aidanpren/BipedV1/README.md

# BipedV1
An open-source balancing biped project. Ran off a Raspberry PI using ROS2 Jazzy Jalisco.
