aidanpren/BipedV1/rock_analysis/rock_A_baseline_analysis.png

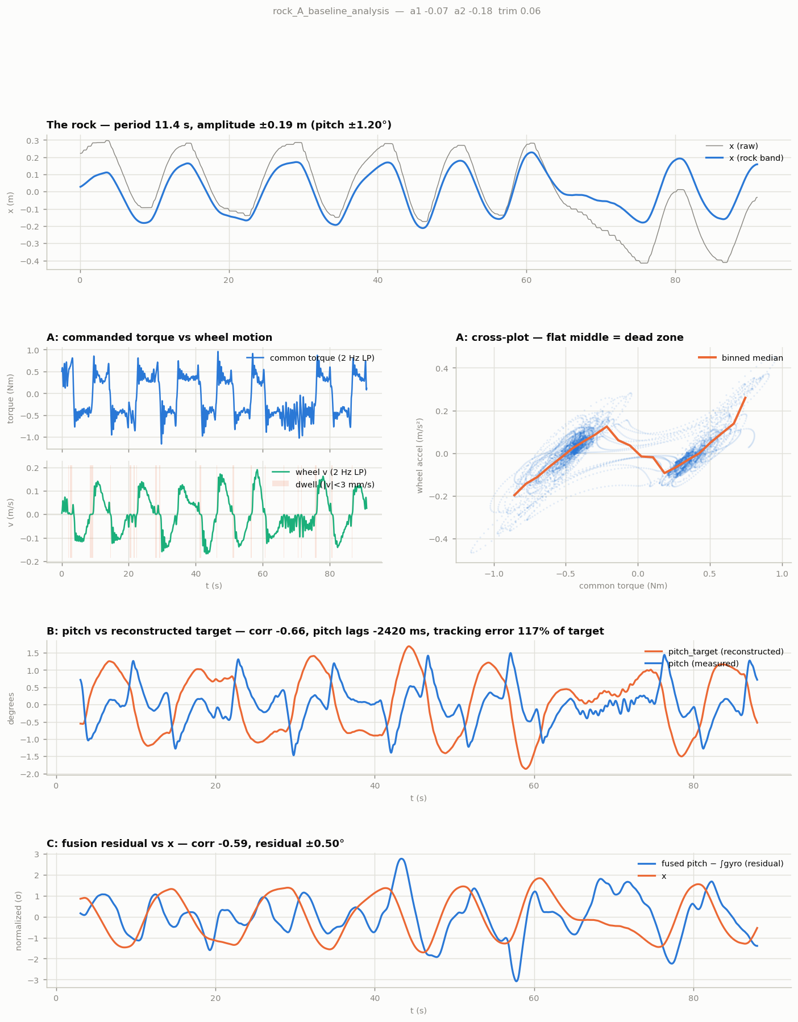
rock_analysis/rock_A_baseline_analysis.png
