aidanpren/BipedV1/rock_analysis/rock_B_nodither_analysis.png

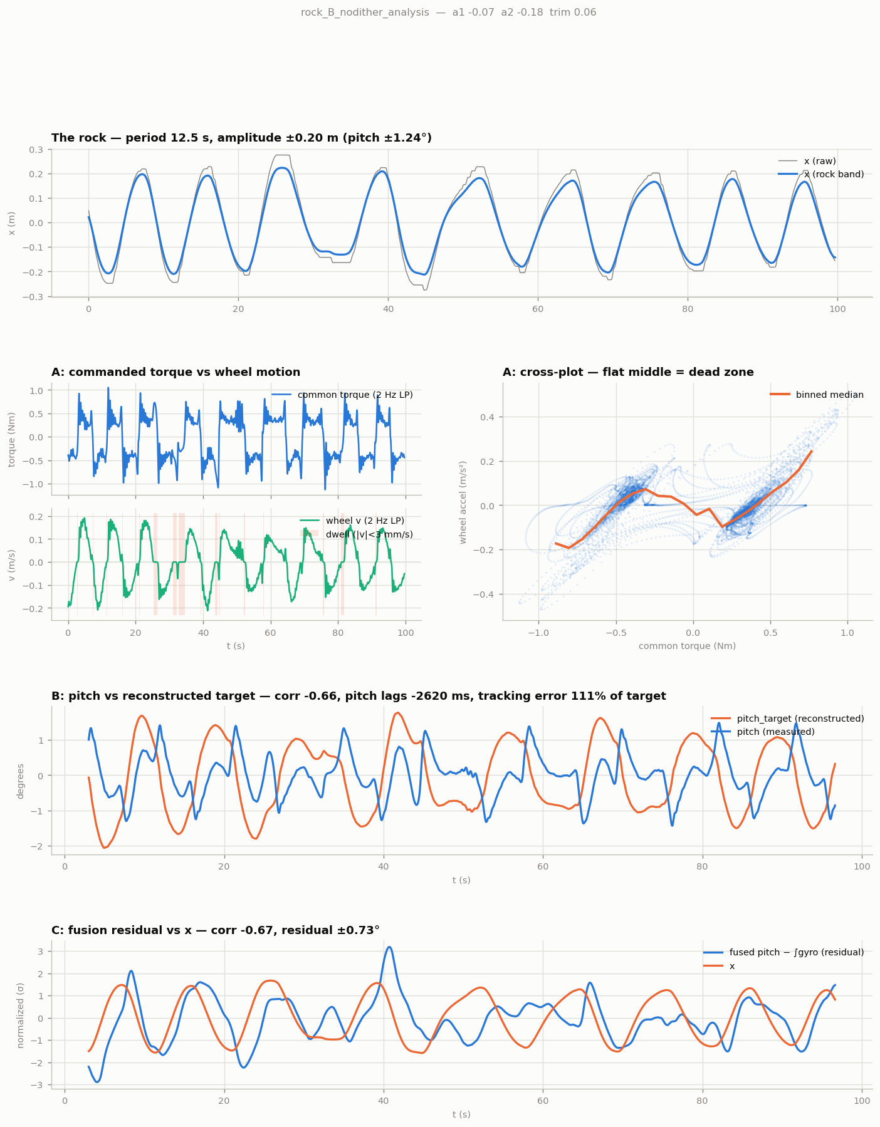
rock_analysis/rock_B_nodither_analysis.png
