aidanpren/BipedV1/rock_analysis/rock_C_frictionff_analysis.png

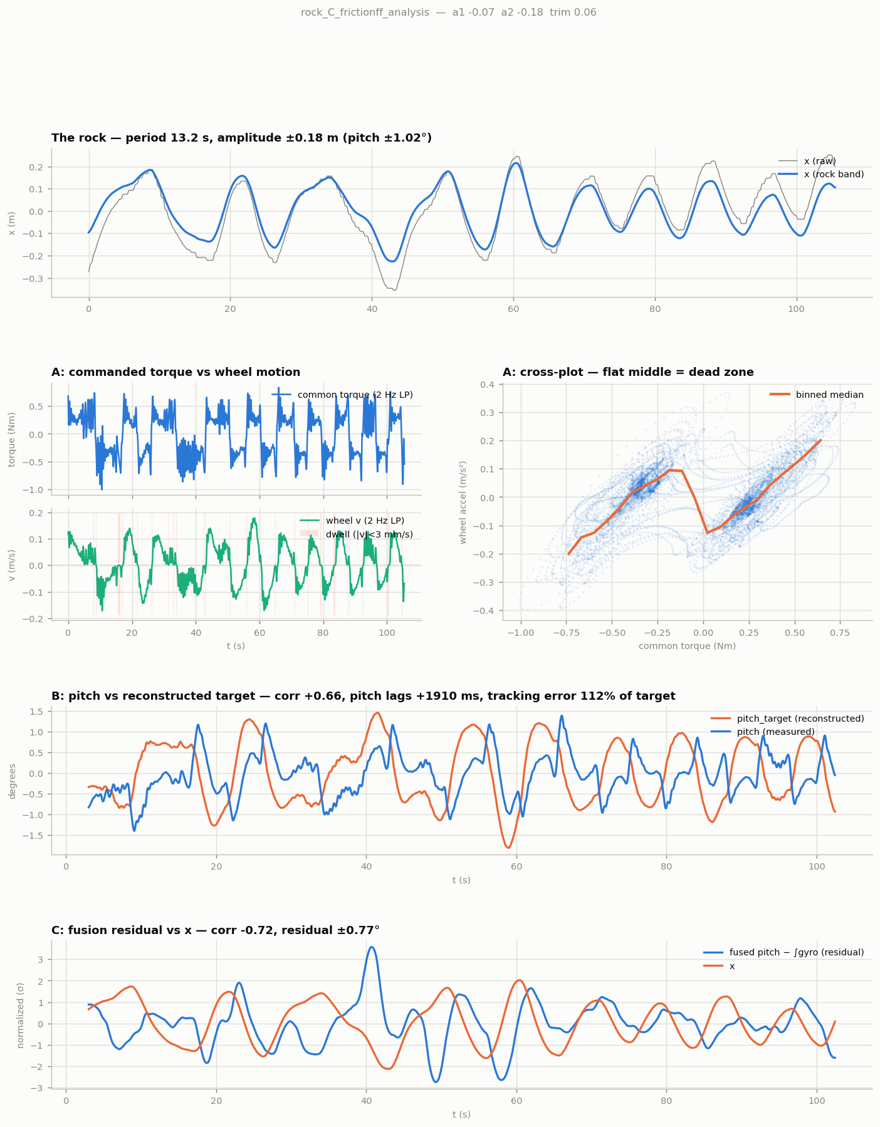
rock_analysis/rock_C_frictionff_analysis.png
