aidanpren/BipedV1/src/robot_description/meshes/_8108_8__X2_7B805316_X0__1.stl

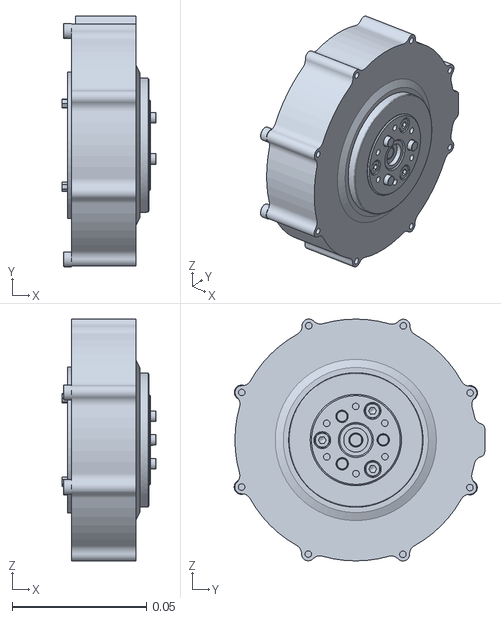
[picture p4: CAD file, 2026-07-09]
src/robot_description/meshes/_8108_8__X2_7B805316_X0__1.stl
0.035 x 0.0933 x 0.0901
