aidanpren/BipedV1/src/robot_description/meshes/Part_2_1.stl

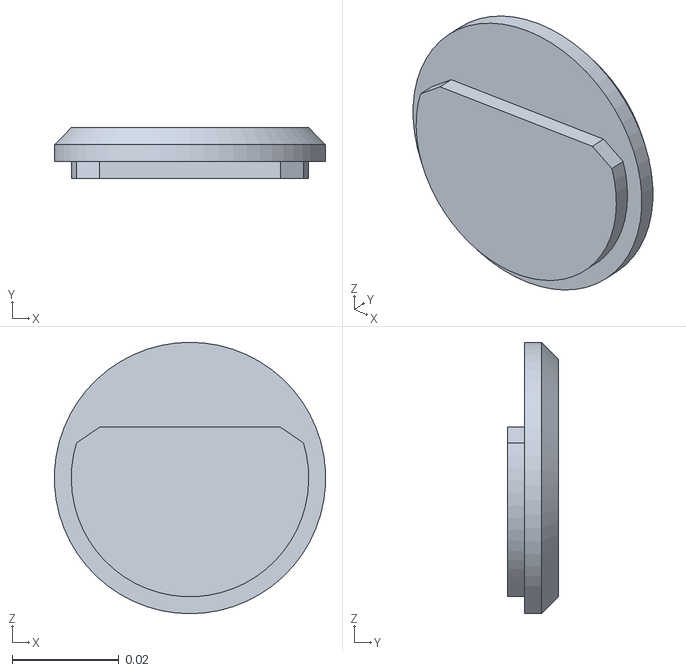
[picture p5: CAD file, 2026-07-09]
src/robot_description/meshes/Part_2_1.stl
0.0507 x 0.00952 x 0.0508
