aidanpren/BipedV1/src/robot_description/meshes/Lidar_A1M8_3.stl

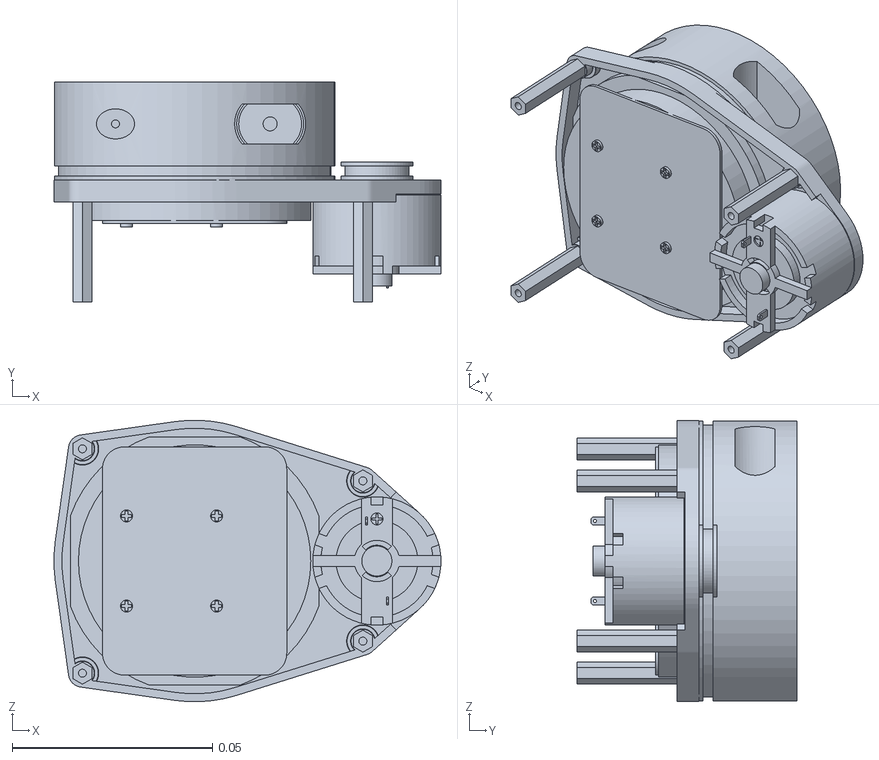
[picture p6: CAD file, 2026-07-09]
src/robot_description/meshes/Lidar_A1M8_3.stl
0.0966 x 0.055 x 0.0702
