aidanpren/BipedV1/src/robot_description/meshes/Part_1_5.stl

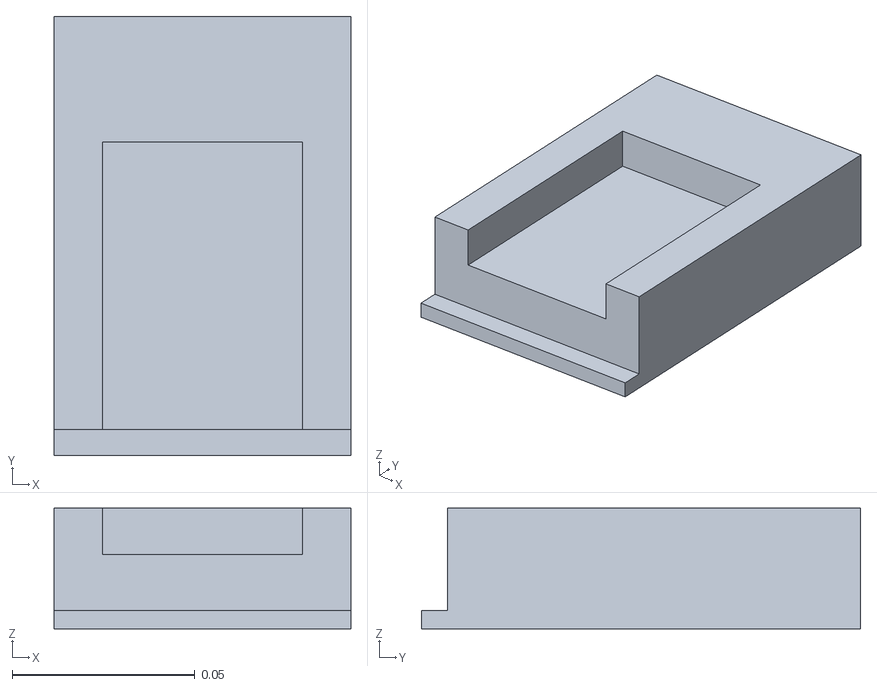
[picture p7: CAD file, 2026-07-09]
src/robot_description/meshes/Part_1_5.stl
0.0813 x 0.12 x 0.033
