aidanpren/BipedV1/src/robot_description/meshes/Part_2.stl

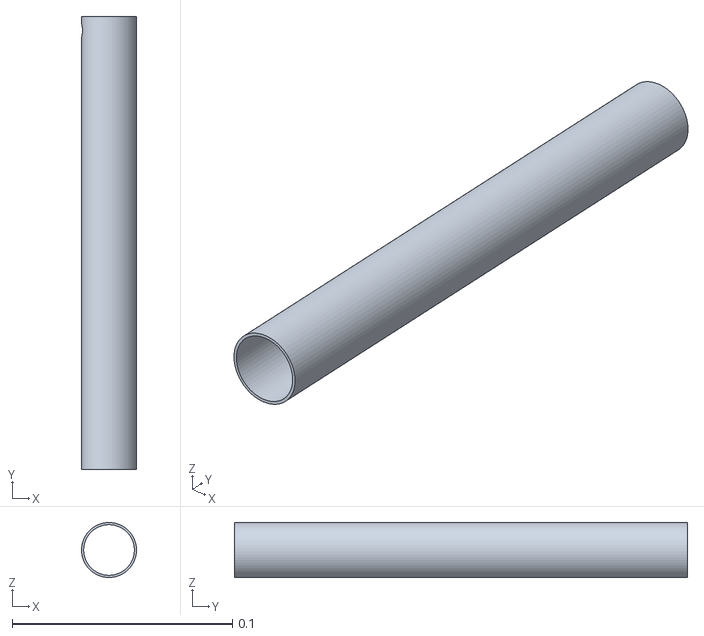
[picture p8: CAD file, 2026-07-09]
src/robot_description/meshes/Part_2.stl
0.025 x 0.206 x 0.025
