aidanpren/BipedV1/src/robot_description/meshes/Part_1_1.stl

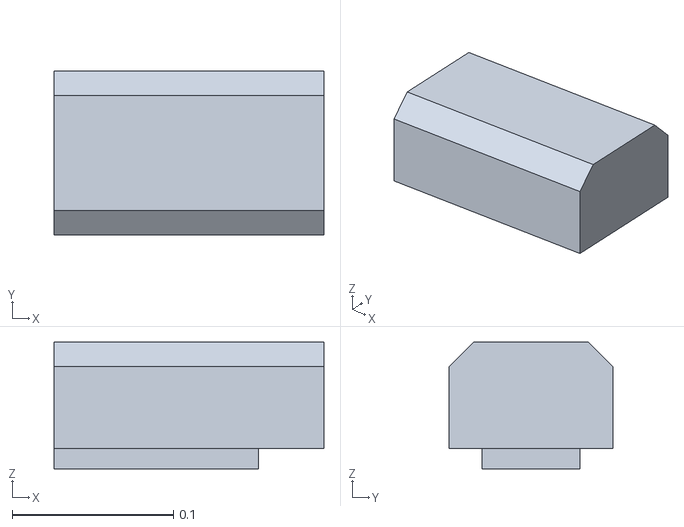
[picture p9: CAD file, 2026-07-09]
src/robot_description/meshes/Part_1_1.stl
0.168 x 0.102 x 0.0787
