aidanpren/BipedV1/src/robot_description/meshes/Lidar_A1M8_6.stl

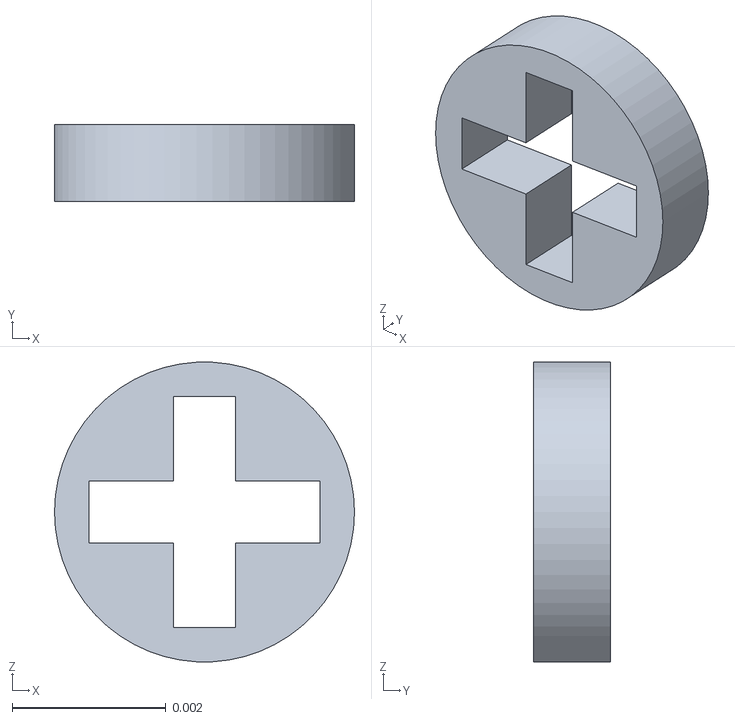
[picture p10: CAD file, 2026-07-09]
src/robot_description/meshes/Lidar_A1M8_6.stl
0.0039 x 0.001 x 0.00389
