aidanpren/BipedV1/src/robot_description/meshes/Part_5.stl

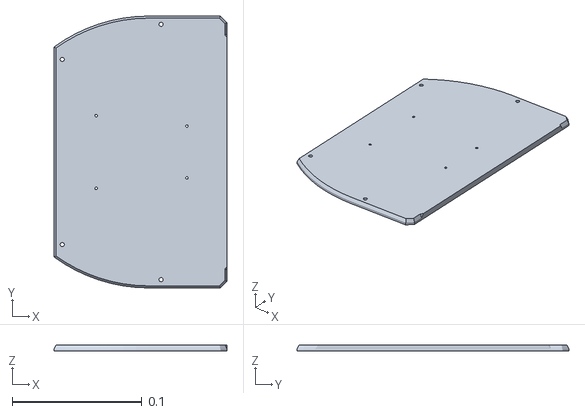
[picture p11: CAD file, 2026-07-09]
src/robot_description/meshes/Part_5.stl
0.133 x 0.21 x 0.00476
