aidanpren/BipedV1/src/robot_description/meshes/Part_1_Mirrored.stl

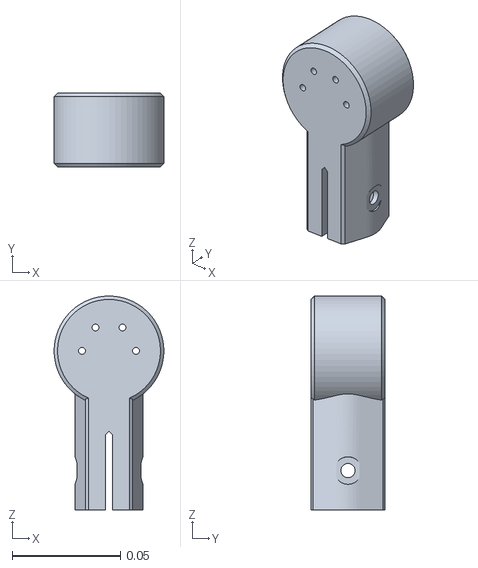
[picture p12: CAD file, 2026-07-09]
src/robot_description/meshes/Part_1_Mirrored.stl
0.0507 x 0.0343 x 0.0991
