aidanpren/BipedV1/src/robot_description/meshes/Part_1_Mirrored_1.stl

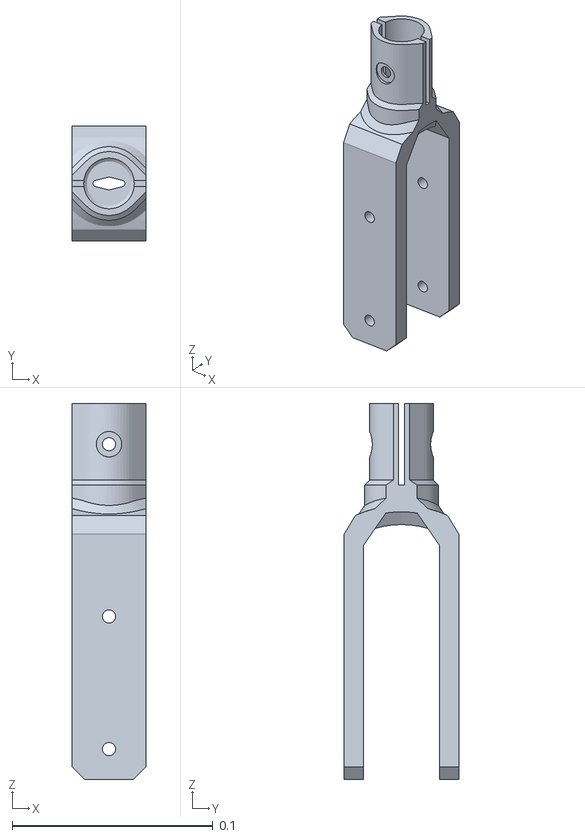
[picture p13: CAD file, 2026-07-09]
src/robot_description/meshes/Part_1_Mirrored_1.stl
0.0367 x 0.0571 x 0.187
