aidanpren/BipedV1/src/robot_description/meshes/Part_3_1.stl

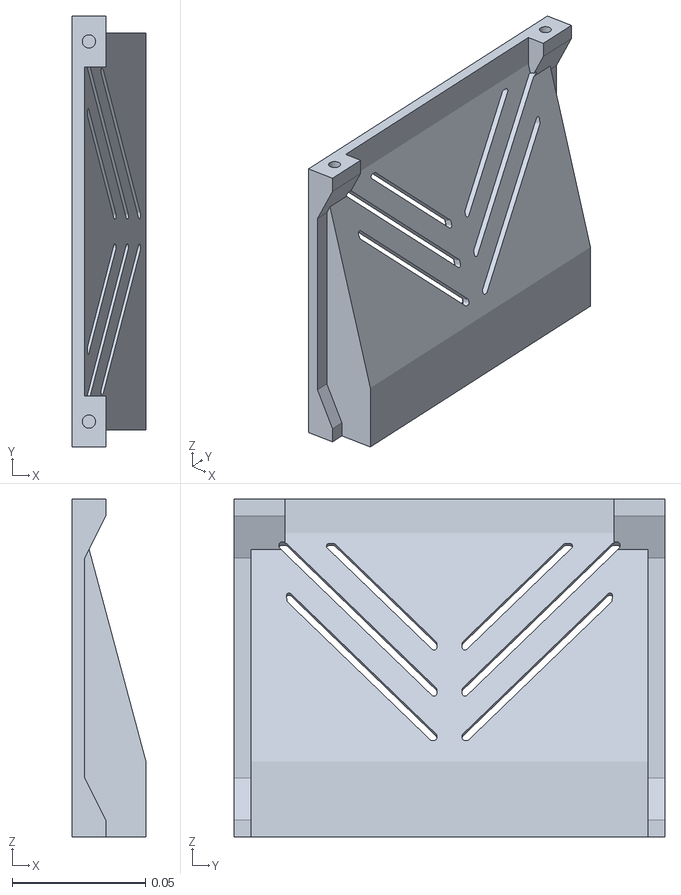
[picture p14: CAD file, 2026-07-09]
src/robot_description/meshes/Part_3_1.stl
0.0278 x 0.162 x 0.127
