aidanpren/BipedV1/src/robot_description/meshes/Lidar_A1M8_5.stl

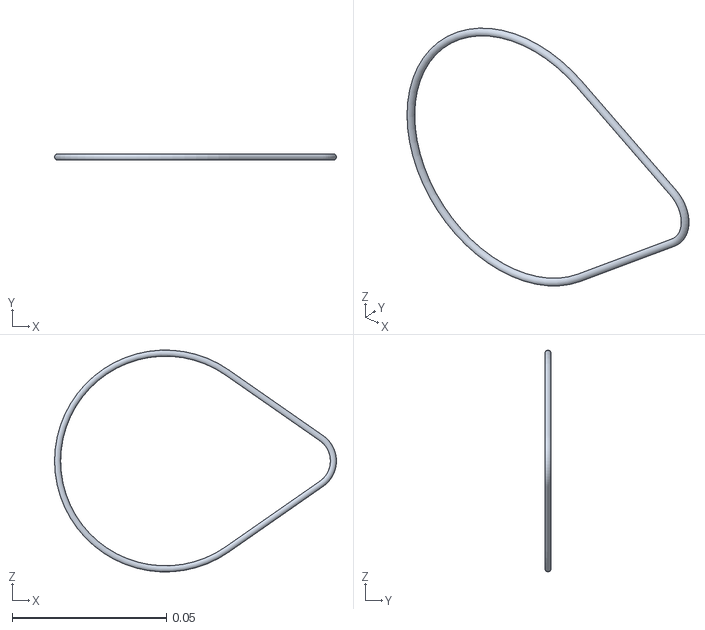
[picture p15: CAD file, 2026-07-09]
src/robot_description/meshes/Lidar_A1M8_5.stl
0.0915 x 0.002 x 0.0719
