aidanpren/BipedV1/src/robot_description/meshes/Lidar_A1M8_2.stl

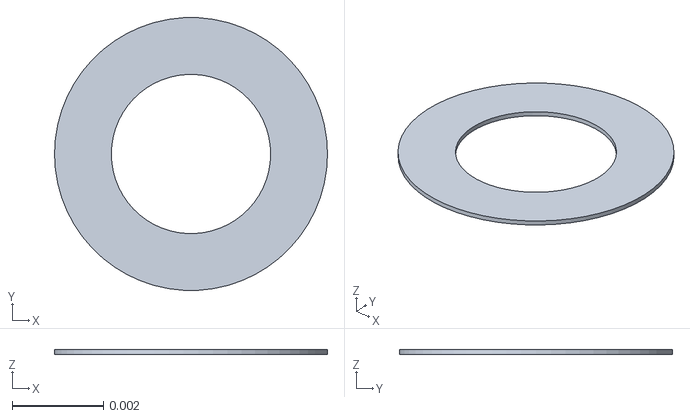
[picture p16: CAD file, 2026-07-09]
src/robot_description/meshes/Lidar_A1M8_2.stl
0.006 x 0.00599 x 0.0001
