aidanpren/BipedV1/src/robot_description/meshes/Part_1.stl

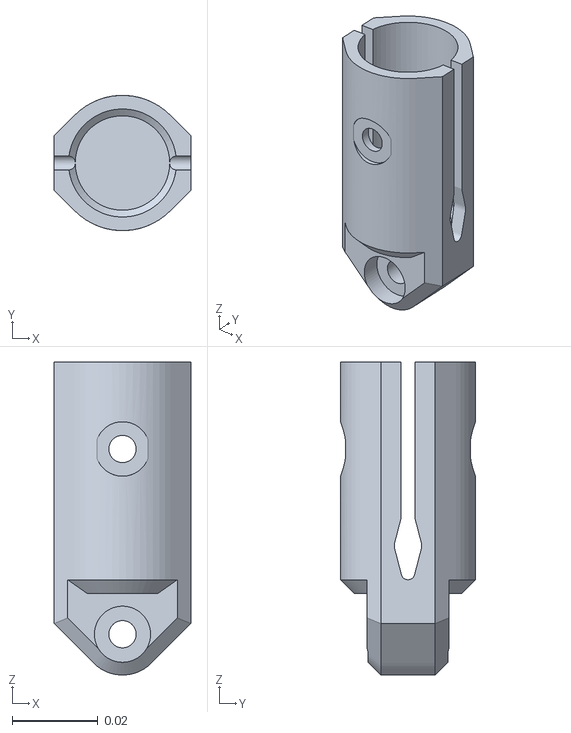
[picture p17: CAD file, 2026-07-09]
src/robot_description/meshes/Part_1.stl
0.0319 x 0.0315 x 0.073
