aidanpren/BipedV1/src/robot_description/meshes/_0_25__ID_Bearing__0_5__OD__0_188__WD__Shielded_.stl

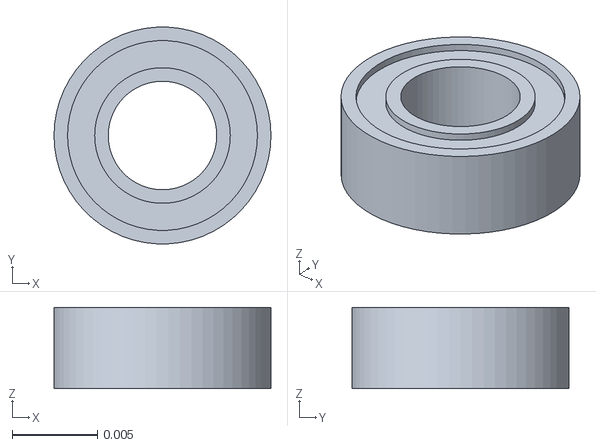
[picture p18: CAD file, 2026-07-09]
src/robot_description/meshes/_0_25__ID_Bearing__0_5__OD__0_188__WD__Shielded_.stl
0.0127 x 0.0127 x 0.00476
