aidanpren/BipedV1/src/robot_description/meshes/Part_1_9.stl

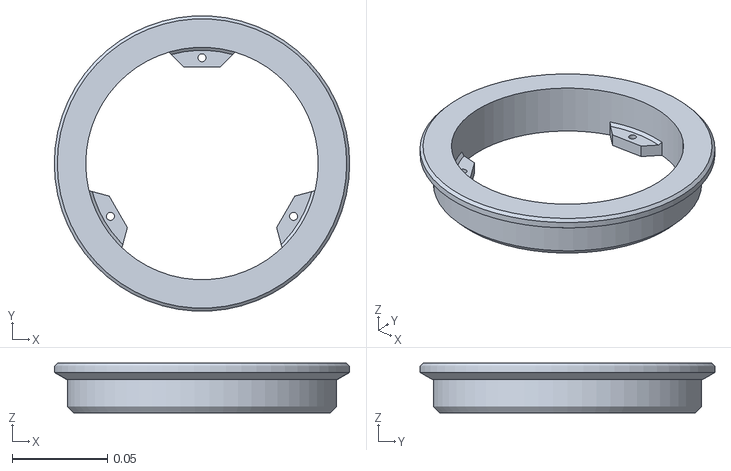
[picture p19: CAD file, 2026-07-09]
src/robot_description/meshes/Part_1_9.stl
0.155 x 0.155 x 0.026
