aidanpren/BipedV1/src/robot_description/meshes/Part_4.stl

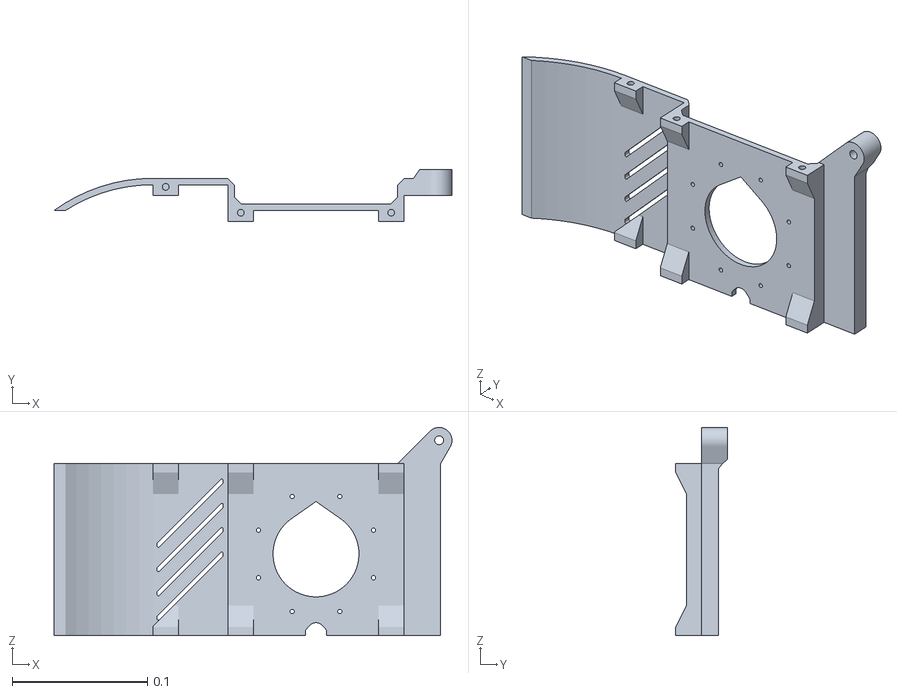
[picture p20: CAD file, 2026-07-09]
src/robot_description/meshes/Part_4.stl
0.294 x 0.0381 x 0.154
