aidanpren/BipedV1/src/robot_description/meshes/Part_6.stl

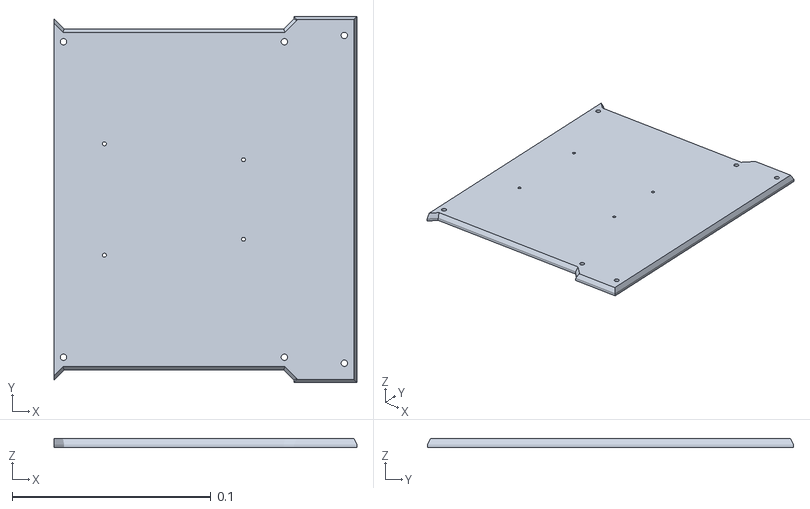
[picture p21: CAD file, 2026-07-09]
src/robot_description/meshes/Part_6.stl
0.152 x 0.184 x 0.00476
