aidanpren/BipedV1/src/robot_description/meshes/Part_3_2.stl

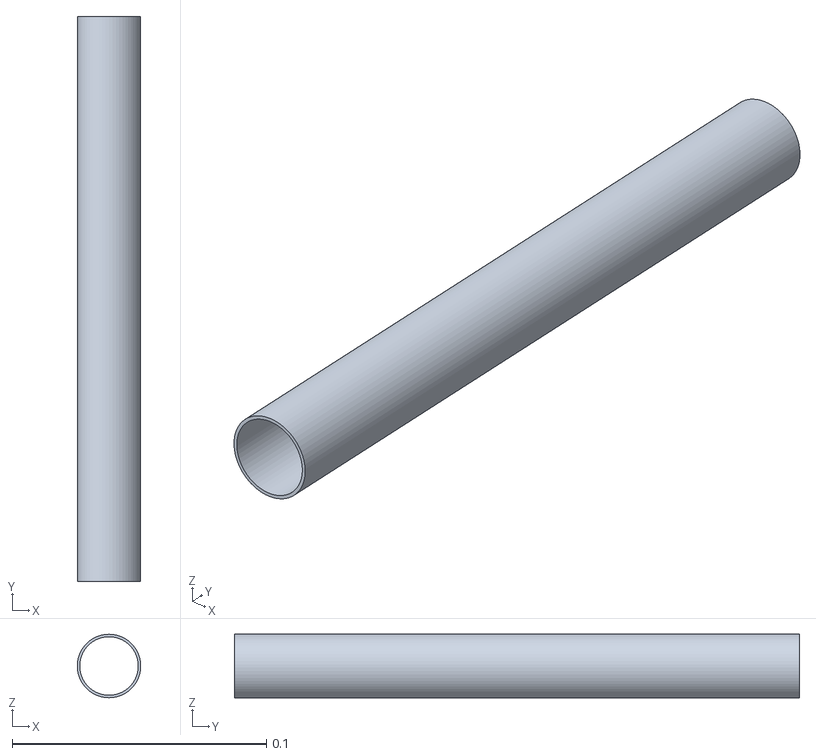
[picture p22: CAD file, 2026-07-09]
src/robot_description/meshes/Part_3_2.stl
0.025 x 0.222 x 0.025
