aidanpren/BipedV1/src/robot_description/meshes/Part_1_2.stl

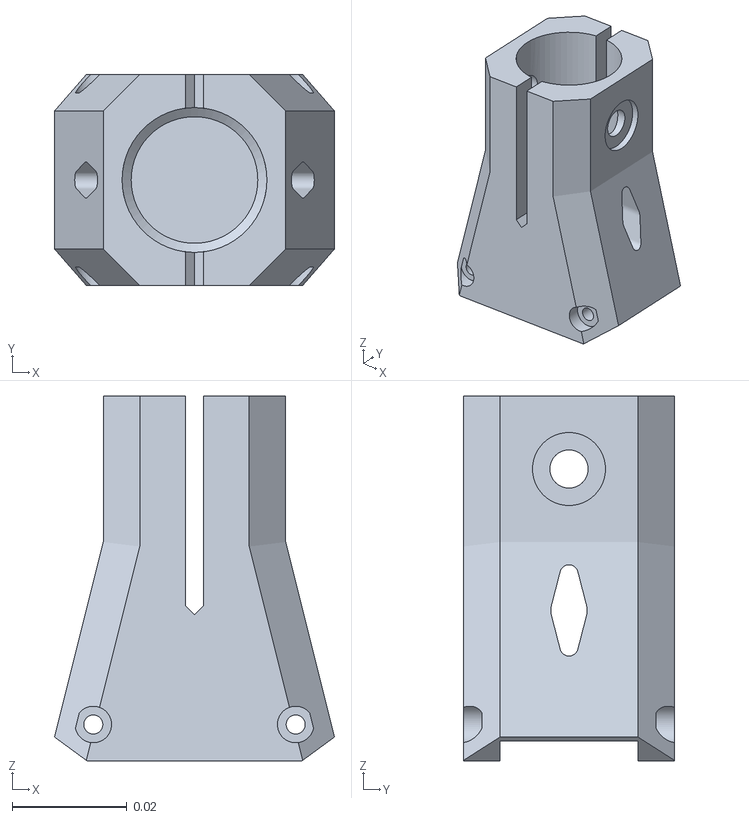
[picture p23: CAD file, 2026-07-09]
src/robot_description/meshes/Part_1_2.stl
0.0487 x 0.0367 x 0.0635
