aidanpren/BipedV1/src/robot_description/meshes/Part_1_8.stl

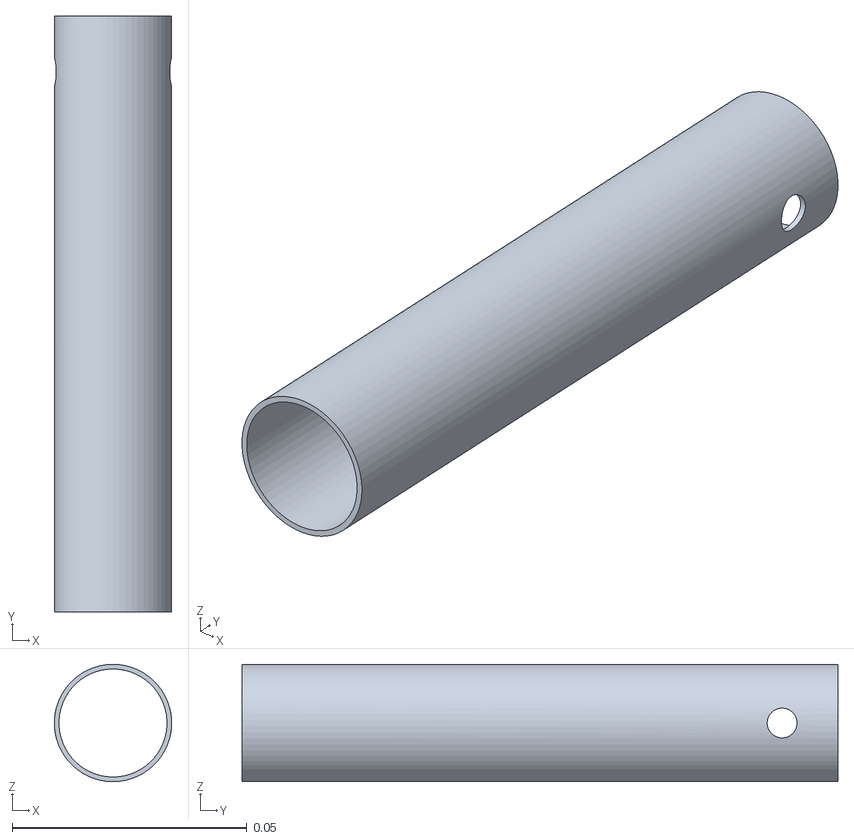
[picture p24: CAD file, 2026-07-09]
src/robot_description/meshes/Part_1_8.stl
0.025 x 0.127 x 0.025
