aidanpren/BipedV1/src/robot_description/meshes/Part_1_4.stl

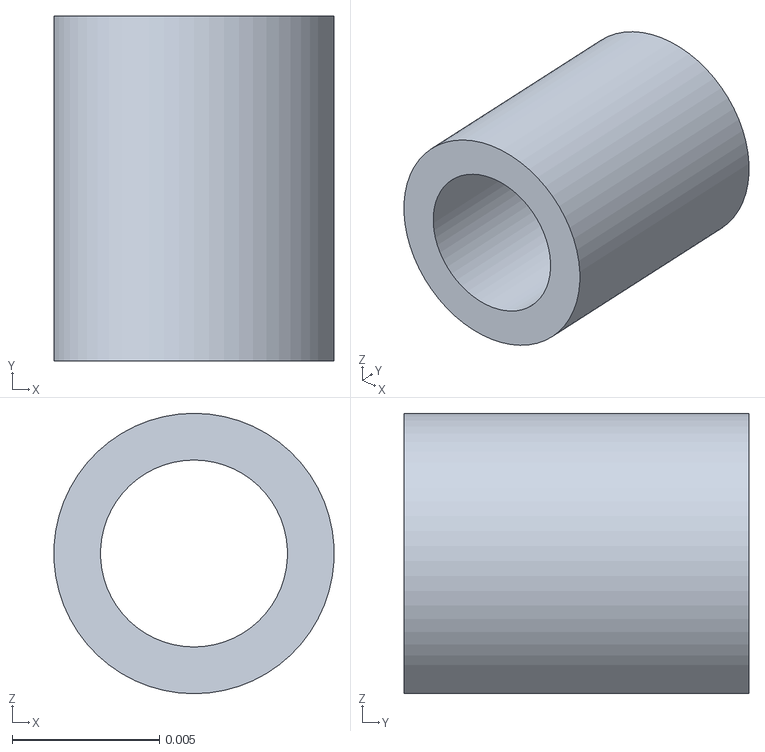
[picture p25: CAD file, 2026-07-09]
src/robot_description/meshes/Part_1_4.stl
0.00951 x 0.0117 x 0.00953
