aidanpren/BipedV1/src/robot_description/meshes/Lidar_A1M8.stl

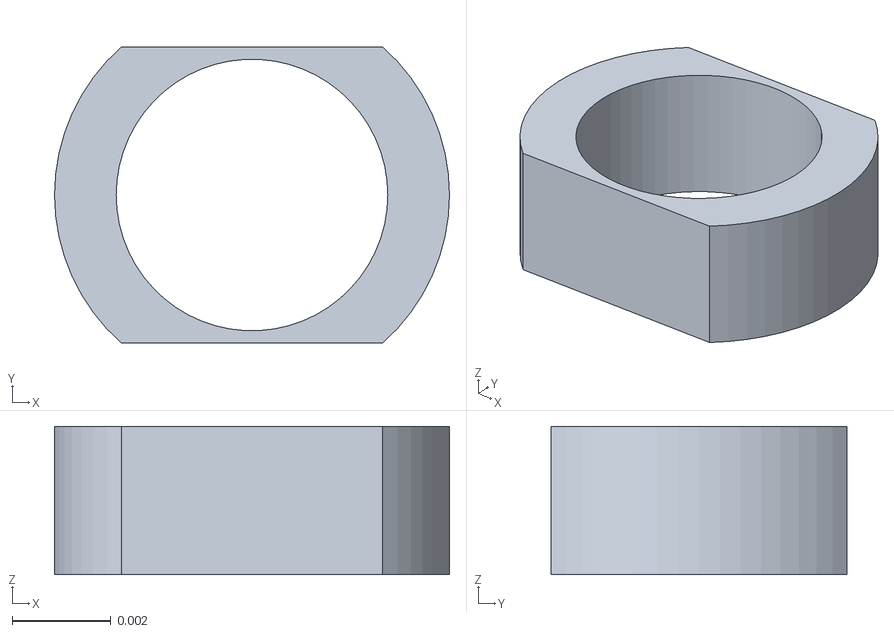
[picture p27: CAD file, 2026-07-09]
src/robot_description/meshes/Lidar_A1M8.stl
0.008 x 0.006 x 0.003
