aidanpren/BipedV1/src/robot_description/meshes/V5_X2_9A7152A876D6_X0__Mirrored.stl

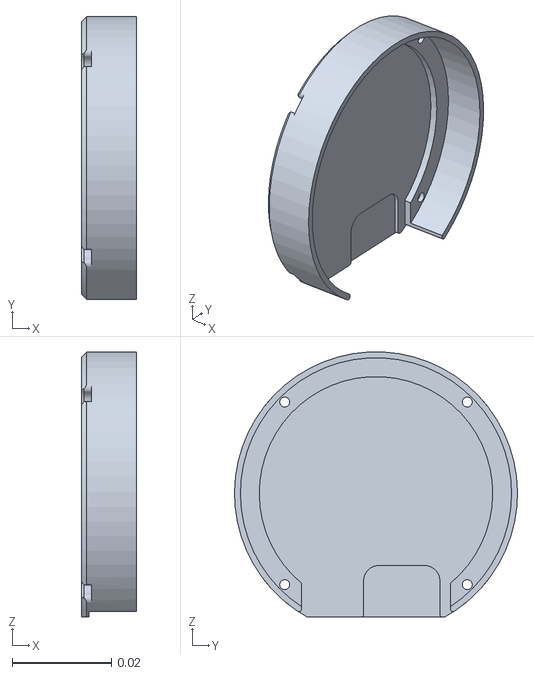
[picture p28: CAD file, 2026-07-09]
src/robot_description/meshes/V5_X2_9A7152A876D6_X0__Mirrored.stl
0.011 x 0.057 x 0.0534
