aidanpren/BipedV1/src/robot_description/meshes/Part_9.stl

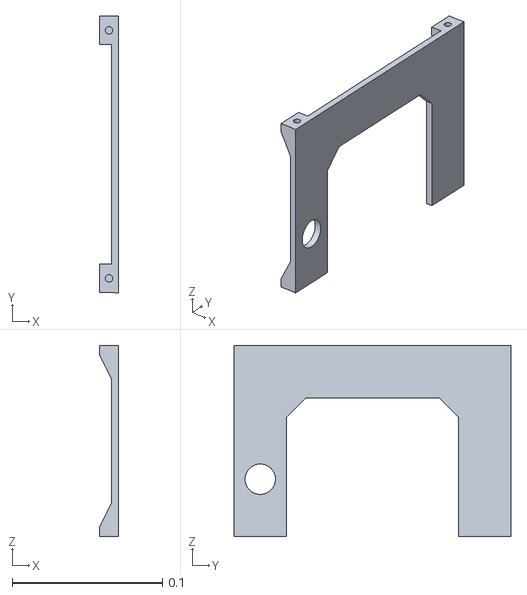
[picture p29: CAD file, 2026-07-09]
src/robot_description/meshes/Part_9.stl
0.0127 x 0.184 x 0.127
