aidanpren/BipedV1/src/robot_description/meshes/Part_3.stl

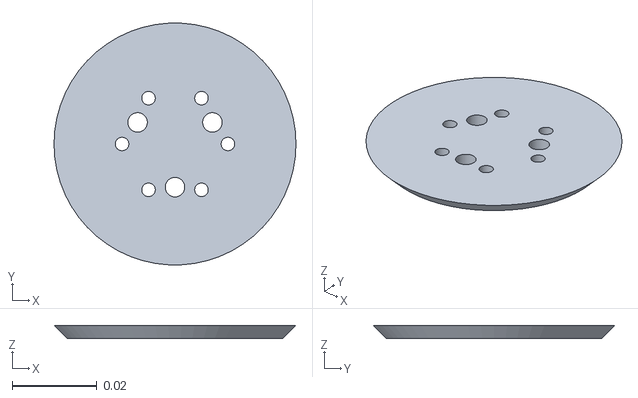
[picture p30: CAD file, 2026-07-09]
src/robot_description/meshes/Part_3.stl
0.0571 x 0.0571 x 0.00317
