aidanpren/BipedV1/src/robot_description/meshes/Lidar_A1M8_4.stl

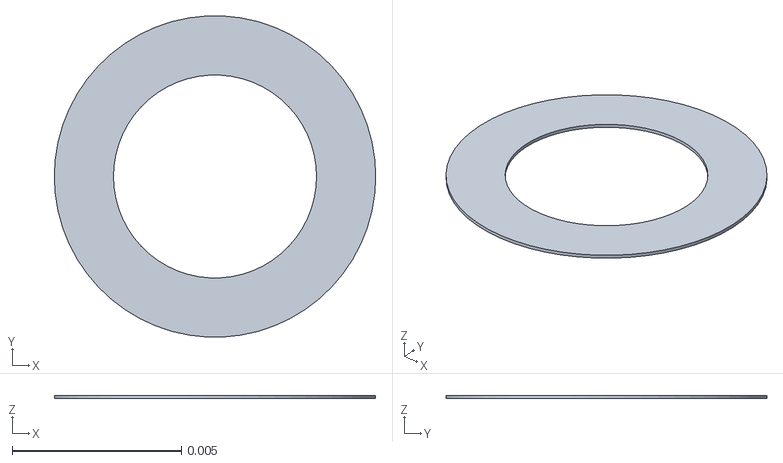
[picture p31: CAD file, 2026-07-09]
src/robot_description/meshes/Lidar_A1M8_4.stl
0.0095 x 0.00949 x 0.0001
