aidanpren/BipedV1/src/robot_description/meshes/Part_1_10.stl

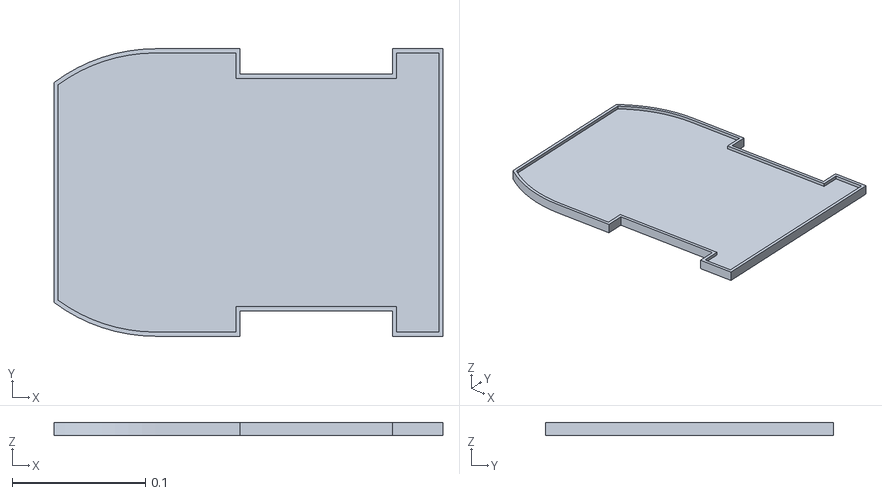
[picture p32: CAD file, 2026-07-09]
src/robot_description/meshes/Part_1_10.stl
0.292 x 0.216 x 0.00953
