aidanpren/BipedV1/src/robot_description/meshes/Part_1_6.stl

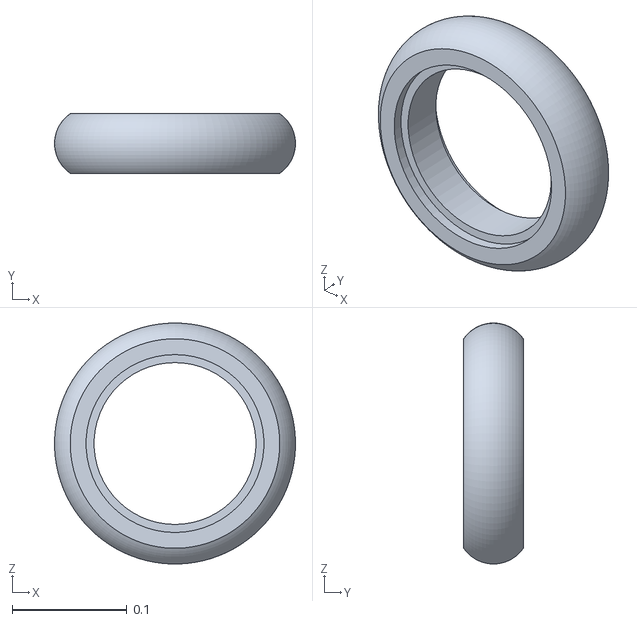
[picture p33: CAD file, 2026-07-09]
src/robot_description/meshes/Part_1_6.stl
0.21 x 0.052 x 0.21
