aidanpren/BipedV1/src/robot_description/meshes/Part_2_2.stl

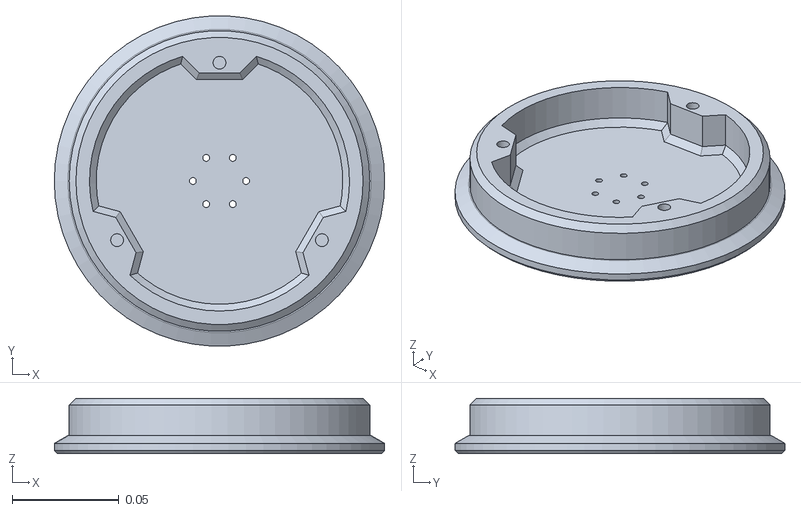
[picture p34: CAD file, 2026-07-09]
src/robot_description/meshes/Part_2_2.stl
0.155 x 0.155 x 0.026
