aidanpren/BipedV1/src/robot_description/meshes/Part_8.stl

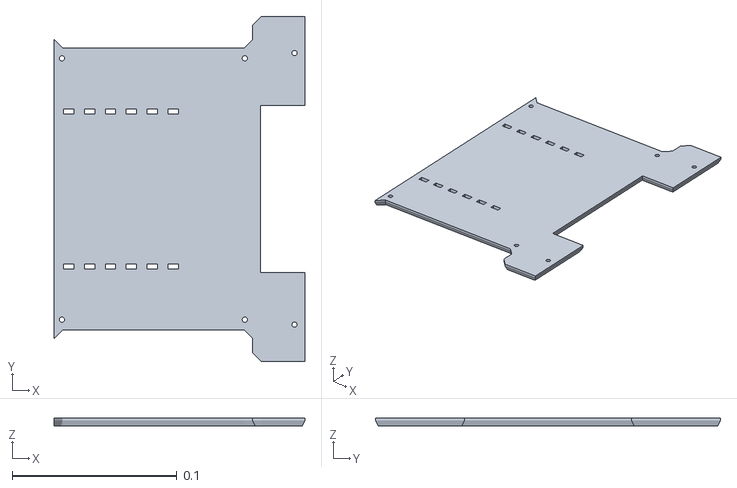
[picture p35: CAD file, 2026-07-09]
src/robot_description/meshes/Part_8.stl
0.152 x 0.21 x 0.00476
