aidanpren/BipedV1/(list of files, cad)

Other CAD files:
src/robot_description/meshes/Part_1_7.stl
src/robot_description/meshes/_8108_8__X2_7B805316_X0__1_Mirrored.stl
src/robot_description/meshes/Part_2_3.stl
src/robot_description/meshes/Part_1_3.stl
src/robot_description/meshes/V5_X2_9A7152A876D6_X0_.stl
src/robot_description/meshes/Lidar_A1M8_1.stl
