aidanpren/BipedV1/(commit log)

2026-07-08 Create base pkgs, create fake_pico and imu_monitor
2026-07-09 Implement twist_mux for input priorities in teleop chain
2026-07-09 Initial URDF / rviz work
    [Lidar_A1M8.stl, Lidar_A1M8_1.stl, Lidar_A1M8_2.stl, Lidar_A1M8_3.stl, Lidar_A1M8_4.stl, Lidar_A1M8_5.stl, Lidar_A1M8_6.stl, Part_1.stl]
2026-07-13 Balance_controller + gazebo implementation
    Unfixed Ricatti equation
    [biped.urdf, biped_sim.urdf, biped_world.sdf, controllers.yaml]
2026-07-16 Gazebo balance_controller tuning & world changess
    [biped_world.sdf]
2026-07-18 Robot interfaces + mode_manager created
    balance_controller not wired to /mode
2026-07-24 (fixed) file cleanup + yaml & symlink fixes
    [fake_odrive.py, imu_node.py, leg_controller.py, odrive_bridge.py, odrive_can.py, test_bridge_vs_fake.py, test_full_stack.py]
2026-07-25 Prismatic joints + leg kinematics
    Awaiting lean control
    [biped_sim.urdf, controllers.yaml]
2026-07-29 Can ID fix real.yaml
    [real.yaml]
2026-07-30 leg_controller: safe startup (read->zero->seed->arm), absolute-encoder zeroing
    The ramp was seeded at home_position before any feedback existed, so the first
    frame on the bus was a full-magnitude position step regardless of where the
    legs actually were. Now: arm in TORQUE at zero torque (this fork only reports
    encoder estimates in CLOSED_LOOP), read, establish the zero, seed the ramp at
    the measured position, then enter POSITION mode.
    Zeroing uses the MA732's single-turn absolute reading via zero_raw_* measured
    once, so the robot never homes. Travel must fit inside one motor turn AND
    leave a dead band as the unwrap error budget, hence pos_max 0.10 not 0.19;
    unwrap_boot() resolves the wrap,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
    [fake_odrive.py, leg_controller.py]
2026-07-30 tools: encoder_probe + imu_calibrate for hardware bring-up
    encoder_probe is read-only and interprets the power-cycle test. imu_calibrate
    computes mount_rpy as conj(q_sensor) with the robot held level, and --verify
    checks it. Fake ODrive now reports zeros outside CLOSED_LOOP, matching the
    firmware behaviour confirmed on hardware.
2026-07-31 Change uart port
2026-07-31 mount rpy
2026-07-31 imu_node: apply mount_rpy on the body side, not the world side
    quat_mul(q_mount, quat) rotates the attitude in the WORLD frame. A sensor
    bolted to a chassis is a BODY-frame relationship, so the correction is a right
    multiply by the conjugate. The old form could be tuned to make a level robot
    read zero -- so it passed calibration -- but did not correct the SIGN of pitch
    as the robot tilts. Found on hardware: a backwards-mounted board read nose-down
    as negative pitch and no mount_rpy value could fix it.
    Adds imu_calibrate --solve, a two-pose (level + nose-down) search over
    axis-aligned mounts. One pose cannot disambiguate the sign, and the sign is
    what decides whether the balance loop catches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
    [imu_calibrate.py, imu_node.py]
2026-07-31 Edit mount_rpy again
2026-07-31 imu_calibrate: --watch prints roll/pitch/yaw in degrees
    The raw quaternion y component is not pitch -- pitch = asin(2*(wy - zx)), so
    reading y alone misleads whenever the mount carries a large yaw, which is
    exactly the case we are debugging. Print the decoded angle and a rising/falling
    hint instead.
2026-07-31 imu_calibrate: one-pose answer follows the body-side correction
    imu_node now right-multiplies by conj(mount), so zeroing a level robot needs
    q_mount = q_sensor, not its conjugate. --solve was already correct; only the
    one-pose path was left inverted.
    [imu_calibrate.py]
2026-07-31 imu: default to I2C (matches wiring) and make silent failure loud
    real.yaml said driver:'uart' while the BNO085 is wired to the I2C pins, so
    --params-file runs produced a node that started cleanly, logged nothing, and
    published nothing. Every working run had been using -p driver:=i2c overrides.
    Adds a 3s liveness check that reports the likely cause when no sample ever
    arrives, instead of sitting silent.
    [imu_node.py, real.yaml]
2026-07-31 docs: record IMU bring-up findings in HARDWARE_BRINGUP
2026-07-31 mount_rpy final?
2026-07-31 imu_calibrate: hemisphere-align samples before averaging
    q and -q are the same rotation and the sensor reports either. With a ~180 deg
    mount yaw, w sits near 0 and samples flip sign constantly; averaging them
    cancelled opposite-signed samples and produced a confident wrong attitude with
    deviation ~2.0. Align every sample to a reference first, and measure spread
    against the mean rather than sample 0.
    [imu_calibrate.py]
2026-07-31 imu_calibrate: --refine folds residual tilt into the applied mount_rpy
    Reads the mount the RUNNING node is using (not the yaml -- overrides beat the
    file), measures what is left, and composes q_new = q_res (x) q_old. Angle
    triples cannot be added; doing the composition by hand is error prone and this
    is the third time it has come up.
    [imu_calibrate.py]
2026-07-31 imu_calibrate: solve the mount geometrically from two physical axes
    The previous calibration baked the robot's HEADING into mount_rpy. A mount is
    a fixed sensor-to-chassis relationship and must contain no heading -- carrying
    one makes the correction a body-frame yaw, which MIXES roll into pitch. That
    is what left a 6.4 deg roll residual that refining could never remove, and why
    composing a residual containing ~180 deg of yaw cancelled the mount's own
    180 deg flip.
    --solve now builds the frame from two heading-independent directions: gravity
    at level gives the robot's up axis in sensor coords, the level->nose-down
    rotation axis gives its pitch axis. Exact for arbitrary mounts, verified at
    he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
    [imu_calibrate.py]
2026-07-31 imu_calibrate: trust gravity over the hand tilt when building the frame
    Orthogonalising UP against the tilt axis let a few degrees of hand wobble tip
    the whole frame — a 6 deg standing roll error on real hardware. Gravity is a
    precise physical reference and the tilt axis is not, so project the tilt axis
    onto gravity's plane instead. Level now reads exactly flat regardless of how
    sloppy the tilt was.
    Residual wobble only skews the in-plane alignment, which cross-couples roll
    into pitch (the balance loop reacts to pitch, so this matters). Report the skew
    and tell the operator to tip the robot on its WHEELS, where the axle sets the
    rotation axis mechanically and the error goes to zero.
    Co-A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
    [imu_calibrate.py]
2026-07-31 please be the last mount_rpy fix
    [real.yaml]
2026-07-31 imu_calibrate: fix --verify, which lost its measurement step
    Removing the dead 90-degree branch also removed the collect/average that
    --verify depended on, leaving a NameError on 'roll'. Give --verify its own
    measurement, report steadiness, and score on roll/pitch only -- yaw is heading,
    not a mount property, and balance never reads it.
    [imu_calibrate.py]
2026-07-31 balance_controller: size max_torque from the measured torque constant
    torque_constant measured at 0.43 Nm/A => motor_kv 19.2 (not the placeholder
    100) => output ceiling 41.3 Nm, so the ODrive current limit does not bind
    first and sim's 40.0 was about right. max_torque 4.0 was low by 10x.
    Set 8.0 for the first ground test: with k3=20 the controller saturates at
    max_torque/20 rad, so 2.0 would have gone flat out at 5.7 deg of tilt while
    8.0 saturates at 23 deg.
2026-07-31 docs: BALANCE_RUNBOOK — full command/expected-result sequence for balance bring-up
2026-07-31 balance_controller: add pitch_trim for a fore/aft-unbalanced chassis
    The equilibrium is where the CoM sits over the contact patch, which is only
    pitch=0 if the robot is balanced fore and aft. A back-heavy robot must stand
    nose-down; holding pitch=0 leaves a constant gravity torque and the only way to
    sustain that angle is to accelerate backwards forever. Presents as an untunable
    steady drift.
    The outer loop can absorb it, but only by carrying a permanent position error
    of pitch_trim/a1 -- parked off home with a1 fighting gravity full time. Stating
    the trim explicitly frees the outer loop for actual disturbances.
    [balance_controller.py, real.yaml]
2026-08-02 teleop: +50% speed/accel; runbook TEST 6 and TEST 3 for the new law
    Speeds raised now that balance_controller shapes the reference: the old
    0.15 m/s cap existed because a full-stick step went straight into a
    proportional term. Driving-loop stability is set by a2 (bandwidth g*|a2|),
    not by top speed, so raising speed does not move the boundary.
    linear 0.15 -> 0.225, turbo 0.3 -> 0.45, yaw 0.5 -> 0.75
    accel_limit 0.3 -> 0.45 so full-stick ramp time stays 0.5 s
    Yaw is still NOT rate-limited: k_yaw*0.75 = 3.0 Nm of differential torque
    arrives as a step, and yaw shares the 8.0 Nm budget with balance. Noted in
    the yaml; shape it before raising yaw again.
    Runbook: adds TEST 6 (stand-side qua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
    [real.yaml]
2026-08-02 docs: session handoff for the standalone-operation milestone
    Records today's state (balance + drive + joystick all passing on the
    rewritten law), the known yaw rate-limiting gap, and the five-piece
    decomposition of "turn on -> hotspot -> website -> drive" with the
    recommended order and the web-deadman design.
2026-08-02 Implemented dither and feedforward to wheels
2026-08-02 Rock diagnosed & fixed: 0.5 Nm friction dead zone; tuned comp made permanent
    tools/analyze_rock.py reads a station-keep rosbag and tests three theories
    at once (dead zone / law tracking / IMU fusion residual). Three bags showed
    commanded torque square-waving at +-0.3-0.5 Nm with zero wheel accel and 8%
    standstill dwell: a ~0.5 Nm breakaway dead zone limit-cycling the outer
    loop (predicts +-0.21 m; measured +-0.19 m). Earlier comp (ff 0.1, dither
    0.15) was 3-5x below breakaway - right medicine, a fifth of the dose.
    Permanent values (verified live on hardware, best behavior to date):
    friction_ff 0.35, friction_v_eps 0.3, dither_torque 0.25
    a2 -0.12 (old -0.18 was damping tuned against the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
    [analyze_rock.py, real.yaml]
2026-08-02 imu_node: supervised retry on BNO085 init — silent hang becomes loud recovery
    First standalone boot found the failure this node could not report: the
    SHTP handshake over Pi I2C fails probabilistically, the Adafruit driver
    polls forever, and the hang sits BEFORE rclpy.spin() where no timer
    (liveness check included) can fire. Robot ends up in TELEOP, deaf, with
    an empty journal. Probed on hardware: the same construction succeeds in
    ~1.5 s on a free bus, so each attempt now runs under a 10 s SIGALRM and
    failures log + retry every 2 s until the sensor answers.
    Offline suite: ALL CHECKS PASSED (fake-driver path untouched).
    [imu_node.py]
2026-08-02 imu_node: log the exact stuck frame when BNO085 init times out
    [imu_node.py]
2026-08-02 real.launch.py: imu_driver default i2c — match the wiring, not the aspiration
    The 'uart' default silently overrode real.yaml's confirmed driver:'i2c'
    on every bare launch, i.e. every systemd boot. Port opened, nothing
    answered, robot booted deaf with every service green. Root cause of the
    first standalone boot failure; found after the retry hardening turned
    the silent hang into named timeouts.
